SteveGeyer/Doris/models/README.md

# Models

This directory holds the 3D models. The following picture shows their overall roles, positions, and names.

Exploded parts

To print these models I generated the STL files using OpenSCAD, sliced them into GCODE with Cura, and printed them in PLA on my Ultimaker 2.
