SteveGeyer/Doris/docs/TwoWheelV2.png

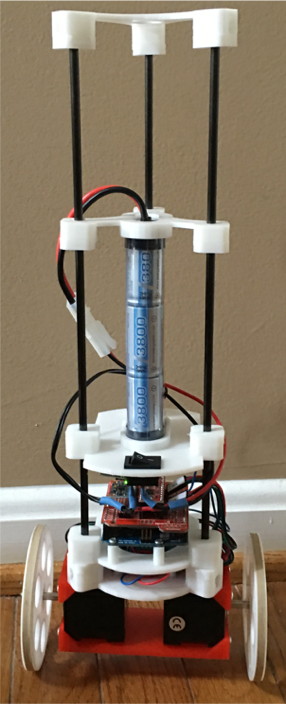
docs/TwoWheelV2.png
