SteveGeyer/Doris/models/omniEdgeWheel.scad

include <lib/commonConstants.scad>
include <lib/stepper.scad>
include <lib/omniWheel.scad>

edgeWheelWithGroove();
