SteveGeyer/Doris/models/omniWheelBottom.scad

include <lib/commonConstants.scad>
include <lib/stepper.scad>
include <lib/omniWheel.scad>

wheelBottom();
