SteveGeyer/Doris/models/omniWheelConnector.scad

include <lib/commonConstants.scad>
include <lib/stepper.scad>
include <lib/omniWheelConnector.scad>

omniWheelConnector();
