SteveGeyer/Doris/models/omniWheelExplodedView.scad

include <lib/commonConstants.scad>
include <lib/stepper.scad>
include <lib/omniWheel.scad>

omniWheelExplodedView();
