SteveGeyer/Doris/models/omniWheelTop.scad

include <lib/commonConstants.scad>
include <lib/stepper.scad>
include <lib/omniWheel.scad>

wheelTop();
