SteveGeyer/Doris/models/threeMotorMount.scad

include <lib/commonConstants.scad>;
include <lib/stepper.scad>;
include <lib/commonMounts.scad>;

threeMotorMount();
