SteveGeyer/Doris/models/threeWheelStand.scad

include <lib/commonConstants.scad>;
include <lib/stepper.scad>;
include <lib/commonMounts.scad>;

threeMotorStand();
