SteveGeyer/Doris/models/twoWheelBaseBottom.scad

include <lib/commonConstants.scad>;
include <lib/stepper.scad>;
include <lib/commonMounts.scad>;

twoWheelBaseBottom();
