SteveGeyer/Doris/models/twoWheelBaseTop.scad

include <lib/commonConstants.scad>;
include <lib/stepper.scad>;
include <lib/commonMounts.scad>;

twoWheelBaseTop();
