SteveGeyer/Doris/models/twoWheelExplodedView.scad

include <lib/commonConstants.scad>;
include <lib/stepper.scad>;
include <lib/commonMounts.scad>;

twoWheelExplodedView();
