SteveGeyer/Doris/models/twoWheelMotorMount.scad

include <lib/commonConstants.scad>;
include <lib/stepper.scad>;
include <lib/commonMounts.scad>;

twoWheelMotorMount();
