SteveGeyer/Doris/models/twoWheelsBaseSkirt.scad

include <lib/commonConstants.scad>;
include <lib/stepper.scad>;
include <lib/commonMounts.scad>;

twoWheelBaseSkirt();
