SteveGeyer/Doris/models/arduinoMount.scad

include <lib/commonConstants.scad>;
include <lib/stepper.scad>;
include <lib/commonMounts.scad>;

arduinoMount();
