SteveGeyer/Doris/models/ballBotExplodedView.scad

include <lib/commonConstants.scad>;
include <lib/stepper.scad>;
include <lib/commonMounts.scad>;

ballBotExplodedView();
