SteveGeyer/Doris/models/batteryBottomMount.scad

include <lib/commonConstants.scad>;
include <lib/stepper.scad>;
include <lib/commonMounts.scad>;

batteryBottomMount();
