SteveGeyer/Doris/models/batteryTopMount.scad

include <lib/commonConstants.scad>;
include <lib/stepper.scad>;
include <lib/commonMounts.scad>;

batteryTopMount();
