SteveGeyer/Doris/models/interiorMount.scad

include <lib/commonConstants.scad>;
include <lib/stepper.scad>;
include <lib/commonMounts.scad>;

interiorMount();
