SteveGeyer/Doris/models/screwMountCap.scad

include <lib/commonConstants.scad>;
include <lib/stepper.scad>;
include <lib/commonMounts.scad>;

screwMountCap();
