SteveGeyer/Doris/(list of files, cad)

Other CAD files:
models/lidarHeadPart1.scad
models/lidarHeadPart2.scad
