SteveGeyer/Doris/schematics/v2/TwoWheelDorisV2.pdf

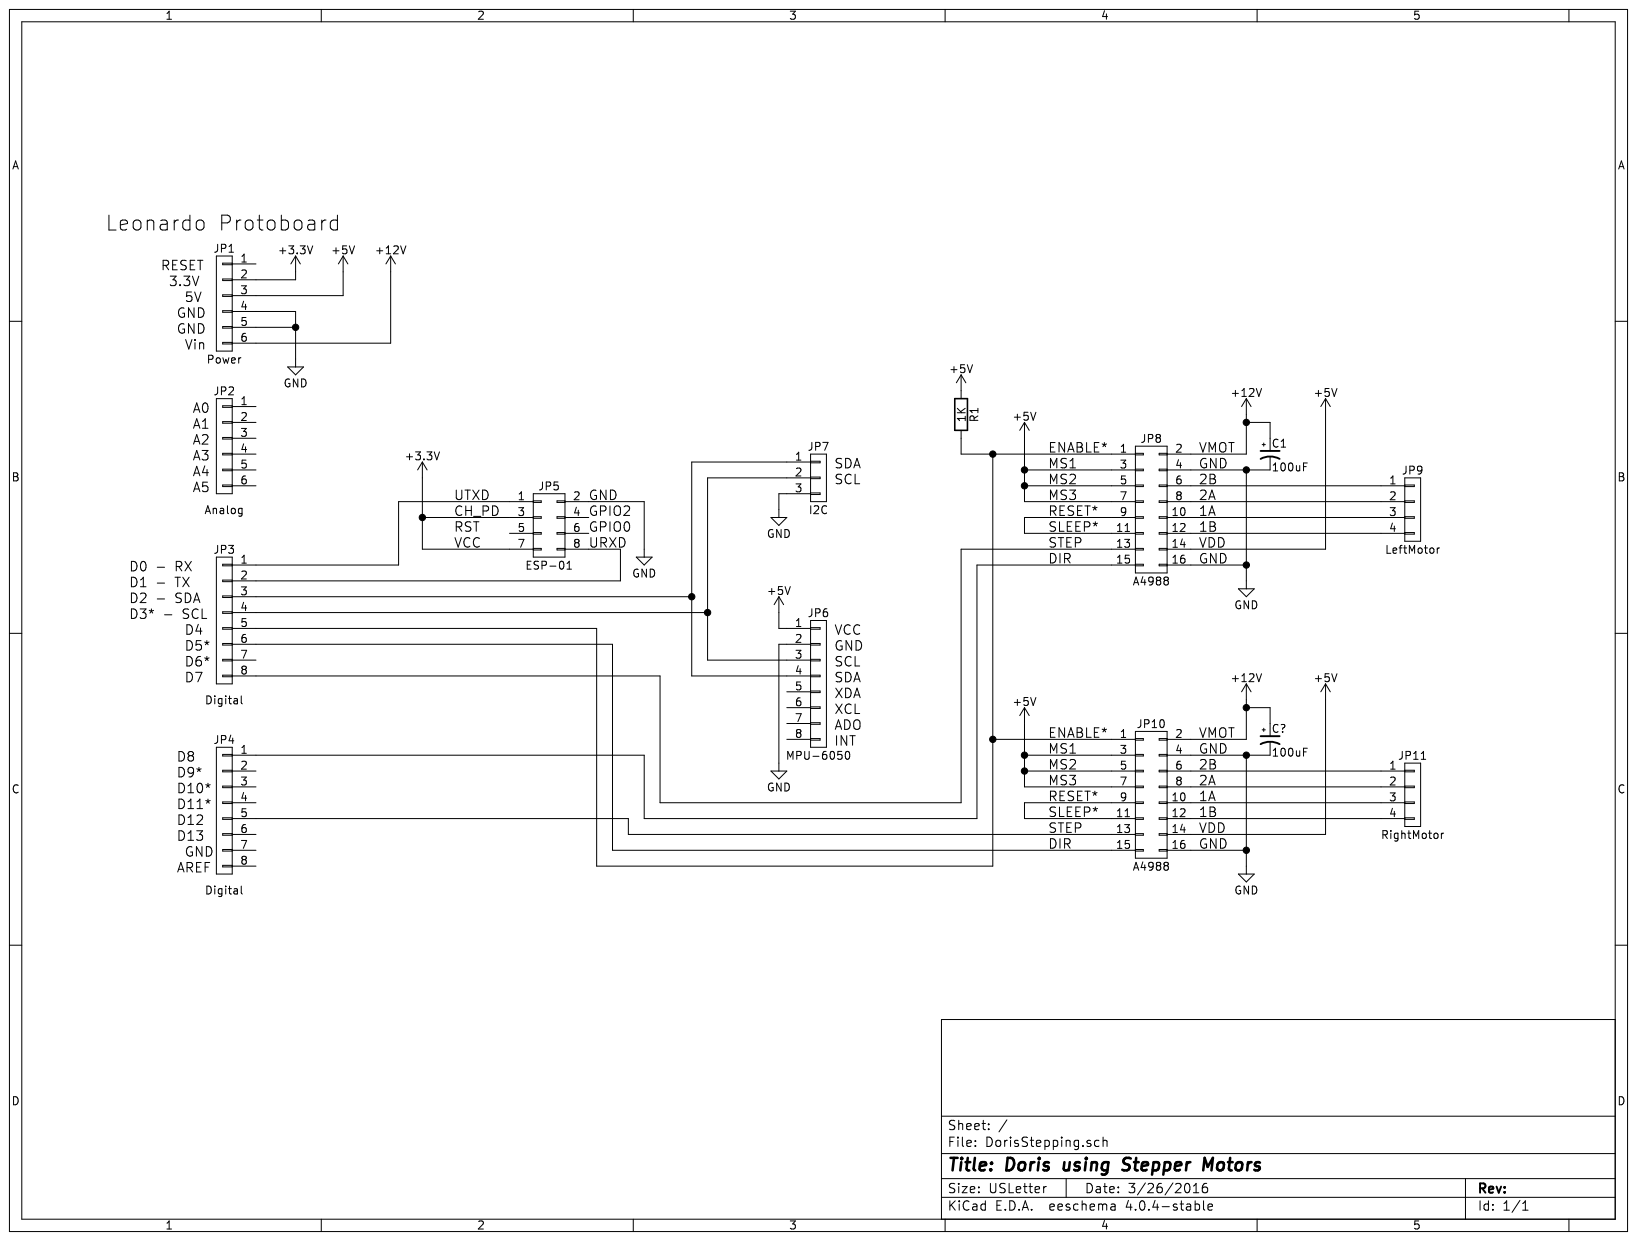
[picture p25: page 1]
