SteveGeyer/Doris/(commit log)

2016-10-30 Initial Doris checkin.
    * Has complete, but not well documented, information on V2.
    * Has schematic for V2.
    * Has the Arduino sketches for V2.
    * Has ballbot 3D models for V3.
    * The 3D models have been completely refactored. Since I have not yet 3D
    printed them all yet there may be a bug or two. I will fix them over
    time.
    [FullExplodedView.scad, arduinoMount.scad, ballBotExplodedView.scad, batteryBottomMount.scad, batteryTopMount.scad, interiorMount.scad, omniEdgeWheel.scad, omniWheelBottom.scad]
2016-10-30 Add V3 balancing and MPU calibration sketches.
2016-11-01 Add threeWheelStand to models.
    [threeWheelStand.scad]
2016-11-06 My first attempt at a v3 ballbot using stepping motors.
    Unfortunately, I discovered that the stepping motors I am using cannot drive
    the omniwheels with enough torque when the omniwheel are being forced to
    slip sideways. I attempted this with two different omniwheels and both
    failed. I believe my next step is to use geared DC motors, but that will
    require redesign.
    Even thought this code was not able to be made to work I am checking it in
    as a starting place for some future ballbot. Be warned that it is in some
    intermediate debugging state.
    [omniWheelConnector.scad]
2016-11-10 Add lower level skirt for two wheel bot.
    [twoWheelsBaseSkirt.scad]
2016-11-10 Add simple LIDAR base.
    [lidarBase.scad, lidarHeadPart1.scad, lidarHeadPart2.scad]
